willevic2002/ultrasonic-array/tools/README.md

# tools

Hjälpskript.

- `draw_sketch.py`: ritar `docs/images/device_sketch.svg` (skiss av enheten). Kör igen om placeringen ändras.
