willevic2002/ultrasonic-array/hardware/mic_placement.csv

ref | x_mm | y_mm | data_net | SEL_pin
U1 | 10.410 | 0.000 | DATA1 | GND
U2 | -9.910 | 9.078 | DATA2 | GND
U3 | 1.390 | -15.841 | DATA3 | GND
U4 | 10.971 | 14.310 | DATA1 | VDD
U5 | -19.629 | -3.473 | DATA4 | GND
U6 | 18.285 | -11.631 | DATA5 | GND
U7 | -6.044 | 22.480 | DATA2 | VDD
U8 | -11.421 | -21.993 | DATA3 | VDD
U9 | 24.609 | 8.988 | DATA6 | GND
U10 | -25.460 | 10.508 | DATA7 | GND
U11 | 12.218 | -26.107 | DATA8 | GND
U12 | 8.993 | 28.675 | DATA6 | VDD
U13 | -27.021 | -15.661 | DATA4 | VDD
U14 | 31.612 | -6.948 | DATA5 | VDD
U15 | -19.248 | 27.375 | DATA7 | VDD
U16 | -4.435 | -34.241 | DATA8 | VDD
