willevic2002/ultrasonic-array/TODO.md

# TODO

Öppna punkter finns som [GitHub Issues](https://github.com/willevic2002/ultrasonic-array/issues),
med etiketterna `hardware`, `fpga`, `software` och `link`.

Ungefärlig ordning:

1. Hårdvara: footprint och porthål (#1), sändare/drivare (#3, #4), kontakt (#5), ledningar och DRC (#2)
2. FPGA: verifiera mot datablad (#6), pinnar (#7), test i hårdvara (#8), CIC och 16 kanaler (#9), TX (#10)
3. Länk FPGA → Pi (#11)
4. Mjukvara: matchat filter (#12), kalibrering och riktig data (#13), ROS 2 (#14)
