willevic2002/ultrasonic-array/hardware/kicad/mic_array.kicad_pcb

## KiCad design hardware/kicad/mic_array.kicad_pcb (2026-10-21)

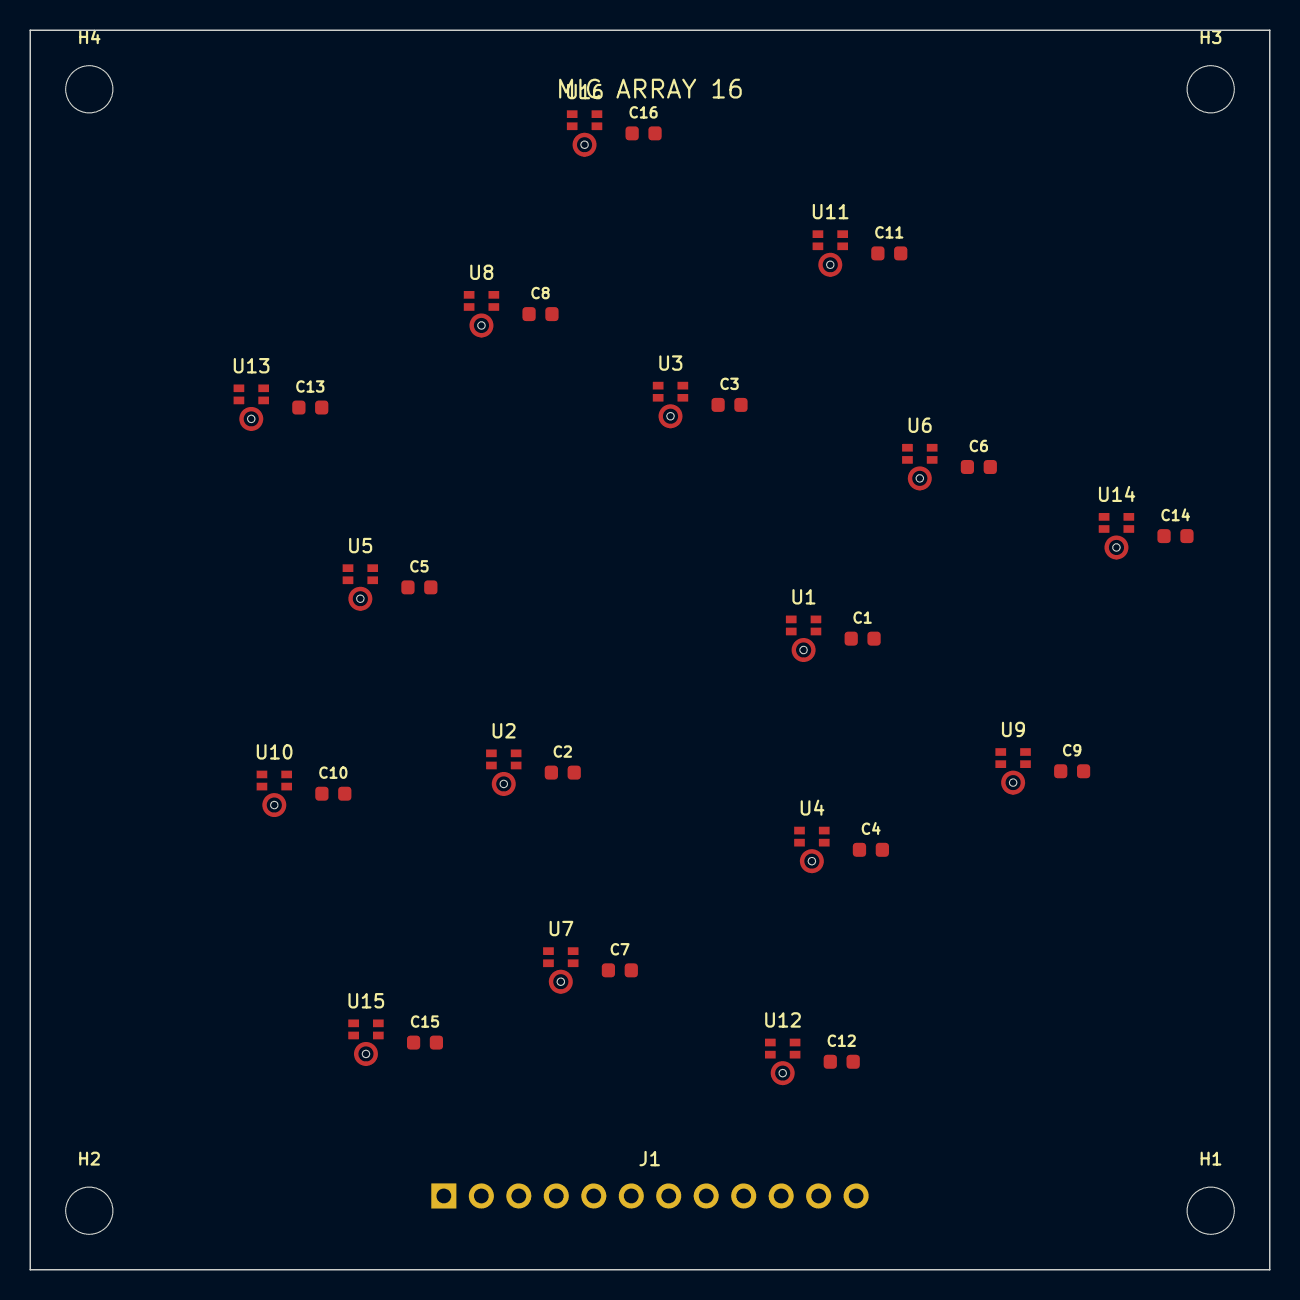
[picture p1: board mic_array.kicad_pcb from above]

Board: 2 copper layers, 84.0 x 84.0 mm, 37 parts (0 on the bottom side), 11 nets, no tracks yet.

Parts:
C1, C2, C3, C4, C5, C6, C7, C8, C9, C10, C11, C12, C13, C14, C15, C16: 100nF C0G; C_0603_1608Metric
H1, H2, H3, H4: M3; MountingHole_3.2mm_M3
J1: CLK D1-D8 3V3 GND GND; PinHeader_1x12_P2.54mm_Vertical
U1, U2, U3, U4, U5, U6, U7, U8, U9, U10, U11, U12, U13, U14, U15, U16: SPH0641LU4H-1; Knowles_LGA-5_3.5x2.65mm

Connections:
+3V3: C1.1, C2.1, C3.1, C4.1, C5.1, C6.1, C7.1, C8.1, C9.1, C10.1, C11.1, C12.1, C13.1, C14.1, C15.1, C16.1, J1.10, U1.5, U2.5, U3.5, U4.2, U4.5, U5.5, U6.5, U7.2, U7.5, U8.2, U8.5, U9.5, U10.5, U11.5, U12.2, U12.5, U13.2, U13.5, U14.2, U14.5, U15.2, U15.5, U16.2, U16.5
CLK: J1.1, U1.4, U2.4, U3.4, U4.4, U5.4, U6.4, U7.4, U8.4, U9.4, U10.4, U11.4, U12.4, U13.4, U14.4, U15.4, U16.4
DATA1: J1.2, U1.1, U4.1
DATA2: J1.3, U2.1, U7.1
DATA3: J1.4, U3.1, U8.1
DATA4: J1.5, U5.1, U13.1
DATA5: J1.6, U6.1, U14.1
DATA6: J1.7, U9.1, U12.1
DATA7: J1.8, U10.1, U15.1
DATA8: J1.9, U11.1, U16.1
GND: C1.2, C2.2, C3.2, C4.2, C5.2, C6.2, C7.2, C8.2, C9.2, C10.2, C11.2, C12.2, C13.2, C14.2, C15.2, C16.2, J1.11, J1.12, U1.2, U1.3, U2.2, U2.3, U3.2, U3.3, U4.3, U5.2, U5.3, U6.2, U6.3, U7.3, U8.3, U9.2, U9.3, U10.2, U10.3, U11.2, U11.3, U12.3, U13.3, U14.3, U15.3, U16.3
