willevic2002/ultrasonic-array/hardware/kicad/mic_test.kicad_pcb

## KiCad design hardware/kicad/mic_test.kicad_pcb (2026-10-15)

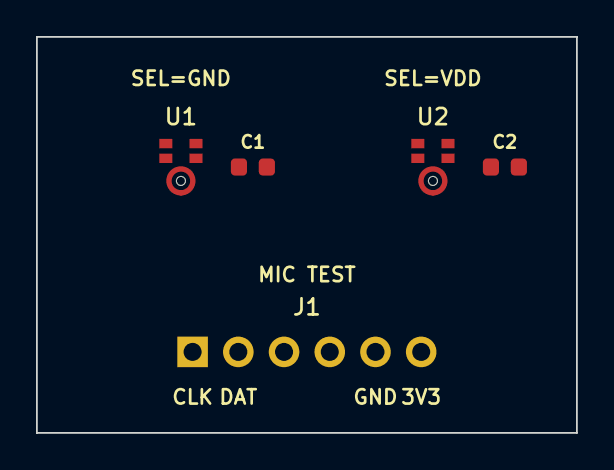
[picture p2: board mic_test.kicad_pcb from above]

Board: 2 copper layers, 30.0 x 22.0 mm, 5 parts (0 on the bottom side), 4 nets, no tracks yet.

Parts:
C1, C2: 100nF C0G; C_0603_1608Metric
J1: PMOD 1 CLK 2 DATA 5 GND 6 3V3; PinHeader_1x06_P2.54mm_Vertical
U1, U2: SPH0641LU4H-1; Knowles_LGA-5_3.5x2.65mm

Connections:
+3V3: C1.1, C2.1, J1.6, U1.5, U2.2, U2.5
CLK: J1.1, U1.4, U2.4
DATA1: J1.2, U1.1, U2.1
GND: C1.2, C2.2, J1.5, U1.2, U1.3, U2.3
