willevic2002/ultrasonic-array/(commit log)

2026-10-15 Add first PCB draft and placement scripts; fix step 1 status in README
    [mic_array.kicad_pcb, mic_placement.csv]
2026-10-15 Add PCB design checks, TX keepout and courtyards; move spiral to r = 8.5*sqrt(i+1)
    The checks found that U1 sat under the transmitter in the board centre.
    [mic_array.kicad_pcb, mic_placement.csv]
2026-10-15 Document field of view: forward dome like Sonair ADAR, multiple boards for 360°
2026-10-15 Add device sketch (front, side with field of view, robot with four units)
2026-10-15 README: step 1 was an HC-SR04 module on STM32; PDM mics untested
2026-10-15 Use real SPH0641 footprint with acoustic port hole; add 2-mic test board
    Footprint is KiCad's Sensor_Audio:Knowles_LGA-5_3.5x2.65mm. The footprint is placed so the
    acoustic port, 0.77 mm from the package centre, sits on the placement point.
    [mic_array.kicad_pcb, mic_test.kicad_pcb]
2026-10-16 Full signal chain without hardware: CIC x16, chirp, capture + SPI, top/pins/build, Pi client, Python model, end-to-end sim
    - fpga: cic_decimator (N=4, R=32), chirp_gen (38-42 kHz, 1 ms), capture_spi + spi_slave,
    mic_array_top, Boolean PMOD pins, tools/build.sh (timing met, WNS 0.700 ns)
    - pdm_pair_capture: drop the junk first valid_f after reset
    - software: pdmsim (scene, PDM, bit-exact CIC), sonar (SPI protocol, device, fake FPGA, matched filter, CLI)
    - fpga/sim/run_e2e.sh: Python scene -> xsim top via SPI -> bit-exact + range/direction check
    [__main__.py, boolean_mic_array.xdc, capture_spi.vhd, chirp_gen.vhd, cic_decimator.vhd, device.py, e2e.py]
2026-10-16 Review fixes: PING_TOGGLE status bit, ASYNC_REG on SPI syncs, fast MISO slew, 8 MHz SPI max, measured LATENCY_SAMPLES; update READMEs
    - capture_spi: status bit 3 toggles per accepted PING; Pi raises if it does not change (lost PING)
    - spi_slave: ASYNC_REG on synchronisers; xdc: SLEW FAST on spi_miso
    - sonar: LATENCY_SAMPLES = 0.8 (measured in run_e2e.sh), used by the CLI
    - build: timing met, WNS 0.996 ns; 2927 LUT, 3901 FF, 16 BRAM36
    [__main__.py, boolean_mic_array.xdc, capture_spi.vhd, device.py, fake.py, protocol.py, spi_slave.vhd, tb_capture_spi.vhd]
2026-10-16 Constant latency, SCLK glitch filter, local resets, pipelined CIC; run_e2e uses software/.venv
    - capture_spi: chirp starts on the next sample_valid after PING, so chirp -> sample 0 is constant (LATENCY_SAMPLES = 1.0, same with different PING timing)
    - spi_slave: SCLK edge needs two equal samples (pulses <~10 ns ignored); max SCLK 8 MHz; testbench injects 6 ns glitches (fails without the filter)
    - mic_array_top: per-instance local reset registers
    - cic_decimator: one integrator per cycle, saturation in its own cycle (still bit-exact)
    - sonar: default SPI 4 MHz
    - build: timing met, WNS 3.965 ns (was 0.4-1.0); 2500 LUT, 3999 FF, 16 BRAM36
    [__main__.py, capture_spi.vhd, cic_decimator.vhd, device.py, e2e_mic_array_top.vhd, mic_array_top.vhd, protocol.py, spi_slave.vhd]
2026-10-16 Add UART-SPI transport and selftest CLI for the Boolean board; note USB now, SPI on final PCB
2026-10-16 Selftest image for the Boolean board: UART-SPI bridge, internal 16-mic PDM pattern
    Verified on hardware: selftest.bit over JTAG, python -m sonar.selftest /dev/ttyUSB1 --pings 3
    -> PASS, every sample of channel c == 2048*(c-8), PING_TOGGLE ok, ~0.9 s per 64 kB capture at 2 Mbaud.
    Sim PASS (tb_selftest_top), timing met WNS 3.740 ns.
2026-10-18 Combine matched filter and delay-and-sum: locate() gives range + direction, sonar --mics (#12)
2026-10-21 Byt sändare till CUSA-T75-18-2400-TH: större keepout och spiral utflyttad (#4)
    [mic_array.kicad_pcb, mic_placement.csv]
2026-10-21 datasheets: CUSA-T75 110 dB gäller vid 10 V, 80 Vp-p är max
